steelpuxnastik/ESPtoPC_Wireless_Remote_Switch/README.md

# ESPtoPC Wireless Remote Switch

Remote power-on / reset / force-shutdown for a desktop PC over WiFi, using an ESP-01 wired to the motherboard's front-panel header, plus an OpenWrt app (LuCI page + CLI) to manage one or more of these boards.

Built for the case where a PC needs to be turned on remotely even after a power outage — before the OS is up, before Wake-on-LAN is usable — by literally pressing the physical power button in software.

## Repo layout

```
├── esptopc_poweron_remote_pcb/
│   ├── esptopc_poweron_remote_pcb.kicad_pro   KiCad project
│   ├── esptopc_poweron_remote_pcb.kicad_pcb   Board layout
│   ├── esptopc_poweron_remote_pcb.kicad_sch   Schematic
│   └── esptopc_poweron_remote_pcb.kicad_prl   KiCad local project settings
├── esptopc_poweron_remote/
│   └── esptopc_poweron_remote.ino             ESP8266 (ESP-01) firmware
└── openwrt_program/
    └── deploy.sh                              One-shot installer for the OpenWrt side:
                                               LuCI app + CLI tool + handshake listener
```

## How it fits together

```
[ESP-01 board]  --HTTP-->  [OpenWrt router]  <--LuCI/SSH--  [you]
   |    ^                     |
   |    |                     |-- LuCI page: device list, status, buttons
   |    `-- commands sent      -- CLI (`esptopcrsw`): menu + one-liners
   |        by OpenWrt         -- receives handshake/heartbeat from ESP
   `-- wired to PC's
       PWR_SW / RESET_SW
       header + reads the
       power-LED line
```

- The ESP-01 runs its own tiny HTTP server (power on / force off / reset / status) and also announces itself to the router (MAC + a fixed identifying string) so it shows up in LuCI ready to be named and saved.
- The OpenWrt side is the "brain": it tracks device state, decides which buttons make sense to show (e.g. no point offering "Reset" on a PC that's already off), and is what you actually interact with — LuCI in a browser, or `esptopcrsw` over SSH.

## Hardware (KiCad project)

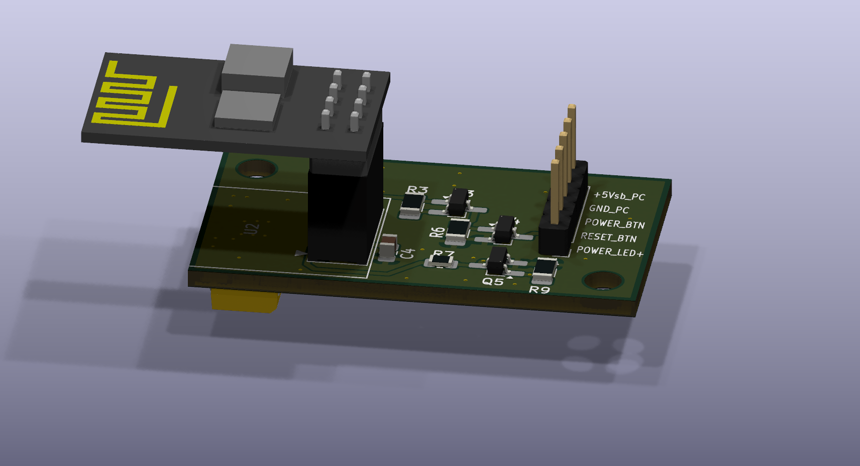
[picture p1: pictures/esptopc_poweron_remote_pcb_1.png]
side

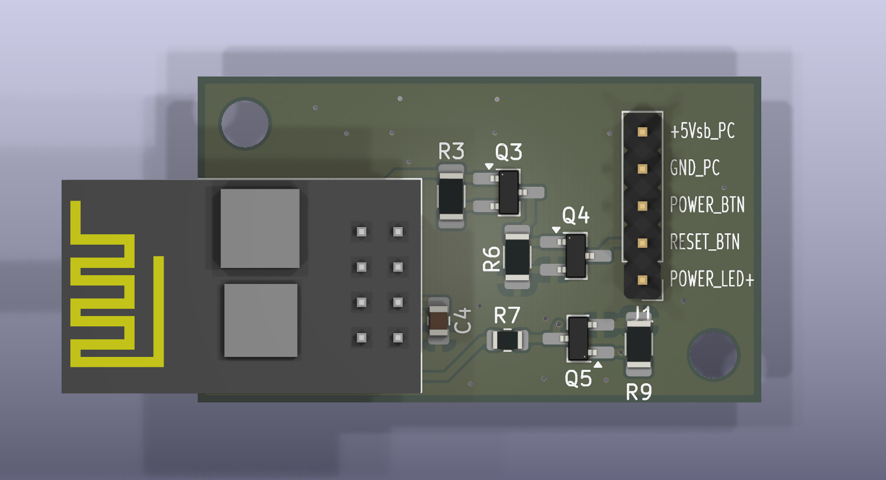
[picture p2: pictures/esptopc_poweron_remote_pcb_3.png]
top

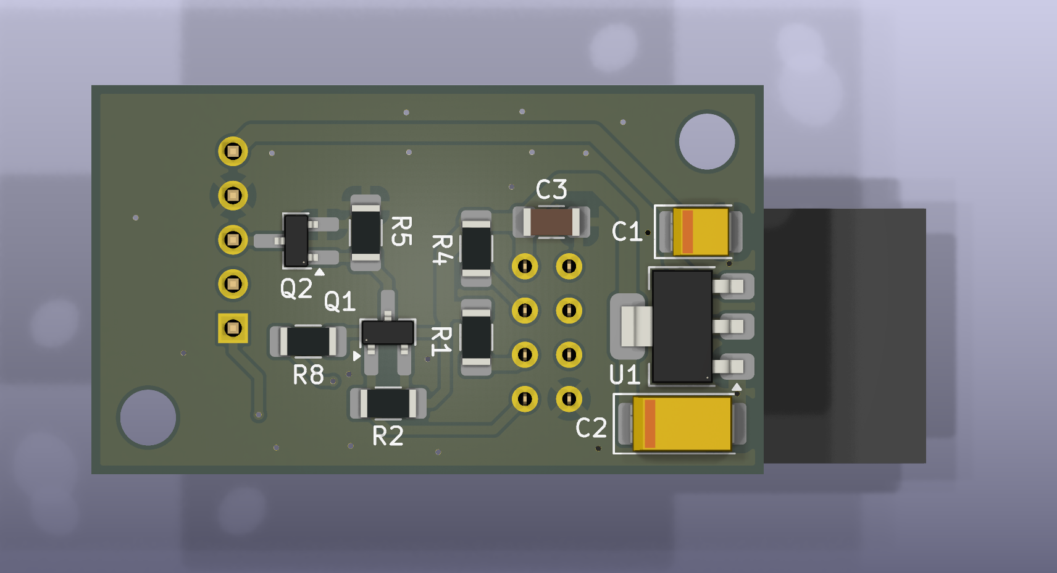
[picture p3: pictures/esptopc_poweron_remote_pcb_2.png]
bottom


Open `esptopc_poweron_remote_pcb.kicad_pro` in KiCad. The board:

- Regulates the PC's 5V standby rail down to 3.3V (AMS1117-3.3) to power the ESP-01;
- Uses two small MOSFET pairs (PMOS+NMOS per line) so the ESP's GPIO1 (TX) and GPIO3 (RX) can pull the motherboard's **PWR_SW** and **RESET_SW** header pins low, exactly like pressing the physical buttons;
- Reads the motherboard's power-LED line through a third MOSFET into GPIO2, to sense whether the PC is currently on (active-low: LOW = on);
- Leaves GPIO0 completely unused/unconnected on purpose, to avoid accidentally dropping into the bootloader.

### List of required components for board assembly

| Reference | Qty | Value | Footprint | Datasheet |
| :--- | :--- | :--- | :--- | :--- |
| **C1** | 1 | 22uF | Capacitor_Tantalum_SMD:CP_EIA-3528-21_Kemet-B_HandSolder | |
| **C2** | 1 | 150uF | Capacitor_Tantalum_SMD:CP_EIA-6032-28_Kemet-C_HandSolder | |
| **C3** | 1 | 100nF | Capacitor_SMD:C_1206_3216Metric_Pad1.33x1.80mm_HandSolder | |
| **C4** | 1 | 1uF | Capacitor_SMD:C_0805_2012Metric_Pad1.18x1.45mm_HandSolder | |
| **J1** | 1 | Conn_01x05_Pin | Connector_PinHeader_2.54mm:PinHeader_1x05_P2.54mm_Vertical | |
| **Q1, Q3** | 2 | IRLML6402 | Package_TO_SOT_SMD:SOT-23_Handsoldering | |
| **Q2, Q4, Q5** | 3 | IRLML2502 | Package_TO_SOT_SMD:SOT-23_Handsoldering | |
| **R1, R2, R3, R4, R5, R6, R8, R9** | 8 | 10k | Resistor_SMD:R_1206_3216Metric_Pad1.30x1.75mm_HandSolder | |
| **R7** | 1 | 1k | Resistor_SMD:R_0805_2012Metric | |
| **U1** | 1 | AMS1117-3.3 (fixed 3.3V version) | Package_TO_SOT_SMD:SOT-223-3_TabPin2 | [Datasheet](http://www.advanced-monolithic.com/pdf/ds1117.pdf) |
| **U2** | 1 | ESP-01 | RF_Module:ESP-01 | [Datasheet](https://aithinker-static.oss-cn-shenzhen.aliyuncs.com/docs/_media_old/esp-01_product_specification_en.pdf) |

## Connection to PC

Connector `J1` (5-pin) goes to the motherboard. Pinout as drawn in the schematic:

| J1 pin | Signal | Connect to |
| :--- | :--- | :--- |
| 1 | LED+ | Power-LED (PLED+) pin of the motherboard's front-panel header |
| 2 | RESET | Signal pin of the RESET_SW header (not the ground pin) |
| 3 | POWER | Signal pin of the PWR_SW header (not the ground pin) |
| 4 | GND | Ground |
| 5 | +5V | +5V standby — must stay powered while the PC is off |

Front-panel header pinouts differ between motherboards, so check the manual of yours before connecting.

## Firmware (`esptopc_poweron_remote.ino`)

Flash with the Arduino IDE (ESP8266 core) via a USB-serial adapter. **TX/RX are used to drive the buttons**, so there's no Serial debug output. Flashing needs the special adapter, so you need to disconnect ESP-01 from the board first.

Before flashing, edit near the top of the file:

- `WIFI_SSID` / `WIFI_PASS` — your network;
- `DEVICE_PASSWORD` — a shared password string. The board sends it to the router in the handshake (so the router knows it's one of yours), and it is also the seed of the per-device command key (see **Security** below). It must match `esptopcrsw.settings.password` on the router; the default `poweron-esp01` is already the same on both sides, so you don't have to change it;
- `POWER_SHORT_MS = 300` - A short press of the Power button. The configured press duration setting should work in most cases;
- `POWER_SOFTOFF_MS  = 4500` - Hold the Power button for the BIOS "soft-off delay" (e.g. Gigabyte: *Soft-Off by PWR-BTN = Delay 4 Sec*: a short press only suspends the PC, holding the button for 4+ seconds turns it off). It is only a fallback: the router normally sends its own time, see **Button press times** below;
- `POWER_FORCEOFF_MS = 5000` - Long-press the Power button to force the system unit to shut down. The required duration of the press can vary significantly between different computers; if it does not work, you will need to experiment to find the right timing;
- `RESET_SHORT_MS = 300` - A short press of the Reset button. The configured press duration setting should work in most cases;
- `WIFI_RETRY_MS = 30000` - While the board is not connected to WiFi (for example, the router is still booting after a power outage), it retries the connection every 30 seconds, forever;
- `HANDSHAKE_INTERVAL_MS = 10000` - Once the board is on WiFi, until the OpenWrt app acknowledges it, it announces itself every 10 seconds;
- `HEARTBEAT_INTERVAL_MS = 90000` - After the acknowledgment the board repeats the announcement every 90 seconds to show it is still alive.

How the heartbeat is used: the router stores the time of the last announcement in RAM, continuously, whether or not anyone has the LuCI page open. A device is shown as Offline if nothing was heard from it for 5 minutes. The PC's on/off state does not come from the heartbeat — it is read live from the board when you open the page (and every 15 seconds while the page stays open). The only case with a wait is right after the router itself reboots: its RAM is empty, so a device shows as Offline until its next announcement (up to the heartbeat interval). A shorter `HEARTBEAT_INTERVAL_MS` shortens that wait.

The board finds the router automatically (`WiFi.gatewayIP()`, no IP to hardcode) and keeps retrying forever, so boot order after a power outage doesn't matter.

HTTP endpoints the board exposes (all require `?key=...`, see below):

| Endpoint | Effect |
|---|---|
| `GET /power/on[?ms=N]` | Short press of the power button (default `POWER_SHORT_MS`; limited to 100–2000) |
| `GET /power/hold[?ms=N]` | Hold the power button (default `POWER_SOFTOFF_MS`; limited to 500–10000) |
| `GET /power/off[?ms=N]`  | Long press, force shutdown (default `POWER_FORCEOFF_MS`; limited to 1000–15000) |
| `GET /reset[?ms=N]` | Press of the reset button (default `RESET_SHORT_MS`; limited to 100–2000) |
| `GET /status` | `{"pc_status":"on"\|"off"}` |

All permission logic (e.g. "don't offer Reset while the PC is off") lives on the OpenWrt side, not in the firmware — the board just does what it's told and reports state.

## OpenWrt app (`deploy.sh`)

Self-contained installer — no package manager involved, just copies files to their real system paths and (re)starts the relevant services. Built against OpenWrt 25.x (APK-based, modern JSON-based LuCI menu/ACL — the classic Lua-controller style LuCI apps won't work the same way on this version).

### Install

On Windows, in CMD, I use this to copy `deploy.sh` to the router:
```CMD
scp X:\way\to\your\deploy.sh root@<router-ip>:/root/
```
After this, connect to the router over SSH and install the app:
```sh
ssh root@<router-ip>
sh deploy.sh
```

Re-running `deploy.sh` after an update is safe — it won't wipe devices you've already added (`/etc/config/esptopcrsw` is only created if missing).

What it sets up:
- LuCI page under **Services → ESPtoPC Wireless Remote Switch**: device table with live status (On / Off / Offline), buttons that adapt to state, add-device picker (from the router's DHCP client list or typed by hand), and a banner for boards that announced themselves but aren't saved yet (it has a Dismiss button; a dismissed board shows up again when it announces itself next time). **Initial setup and adding devices is carried out only in LuCI's ESPtoPC Wireless Remote Switch program page**;
- `esptopcrsw` CLI (see below; use it only after the setup in LuCI is done and checked);
- A second `uhttpd` instance on port 8090 that receives the handshake/heartbeat from ESP boards;
- `rpcd`/`ubus` backend (`/usr/libexec/rpcd/esptopcrsw`) that both the LuCI page and the CLI talk to.

### CLI

> **Important:**
> Use the CLI only after the program is set up in LuCI and you have checked that everything works as you expect: devices are added, the status is shown correctly, and the press times (the **Settings** button of each device) fit your PC. The CLI does not add devices or change settings, it only sends commands using what is configured in LuCI.

```sh
esptopcrsw                     # interactive menu, a convenient alternative to manual command entry
esptopcrsw list                # table of devices + status
esptopcrsw poweron <name>      # power on (or sleep, if already on)
esptopcrsw softoff <name>      # soft-off: hold Power for the BIOS delay (see below; `hold` is an alias)
esptopcrsw off <name>          # force power off (long hold)
esptopcrsw reset <name>
esptopcrsw check <name>        # check/restore connection
esptopcrsw help                # show help (list of commands and hints)
esptopcrsw lang [en|ru|uk]     # interface language (remembered)
```

Any of `poweron` / `softoff` / `off` / `reset` asks for a one-letter confirmation first (`y/N`) naming the device and the action, so a stray keypress can't send a command to the wrong PC. If a device looks offline when you run a command, the CLI tries to reconnect first and reports what happened, instead of failing silently.

### Button press times and Soft-Off

**Soft-Off is optional and aimed at Gigabyte boards.** Some Gigabyte BIOSes have *Soft-Off by PWR-BTN* (*Instant-Off* / *Delay 4 Sec*). With *Delay 4 Sec* a short press only suspends the PC, and a press held for 4 seconds shuts it down normally. If your board has no such option, you only need **Off / Sleep** and **Force Off**. The same action also covers any other case where the PC expects a Power press of a specific length: set that length as the hold time.

Power button actions, from shortest to longest: **Off / Sleep** (short press, what the PC does depends on its power settings), **Soft-Off (X s)** (hold for the BIOS soft-off delay), **Force Off** (long hold, `POWER_FORCEOFF_MS`), and **Reset**.

If a short press does not shut the PC down (on Gigabyte boards the BIOS option *Soft-Off by PWR-BTN* set to *Delay 4 Sec* makes a short press only suspend it), use **Soft-Off (X s)**. `X` is set with the **Settings** button in LuCI (in seconds) or on the router, no reflashing needed:

All press times are set per device in LuCI, in seconds, no reflashing needed: the **Settings** button in the device's *Manage* column (an empty field means the built-in value). The same options can be set with `uci` in the device section:

```sh
uci set esptopcrsw.@device[0].soft_off_ms='6000'    # the first device, ms
uci commit esptopcrsw
```

| Option | Action | Default | Allowed, ms |
|---|---|---|---|
| `power_short_ms` | Off / Sleep (short Power press) | 300 | 100–2000 |
| `soft_off_ms` | Soft-Off (Power hold for the BIOS delay) | 4500 | 500–10000 |
| `force_off_ms` | Force Off (long Power hold) | 5000 | 1000–15000 |
| `reset_ms` | Reset | 300 | 100–2000 |

The Soft-Off button label in LuCI and in the CLI shows the current value for that device. Unlike the short press, this button is not blocked in the first minute after power-on.

### Security

There's no login/password on the ESP's HTTP server itself — instead:

- **Handshake** (ESP → router): the board POSTs its MAC and `DEVICE_PASSWORD` to the router on boot/periodically, so the router knows it's genuinely this project's firmware announcing itself. It only filters out random devices, and it is sent in plain text.
- **Commands** (router → ESP): every `/power/on`, `/power/hold`, `/power/off`, `/reset`, `/status` call requires `?key=<12-hex-chars>`, computed as `md5(MAC:DEVICE_PASSWORD)` truncated to 12 characters — the same formula on both sides, so no separate secret needs to be distributed or synced per board. Each board gets a different key because its MAC is different. This stops a stray browser tab pointed at the board's IP from doing anything. It is **not** protection against someone who deliberately reads this repo (the formula and the default password are public), and it's **not encryption**: the key is part of the URL, so anyone sniffing the WiFi traffic can read it in plain text. Good enough for "don't let someone on the LAN poke it by accident", not meant to survive a hostile network. If you want more than the default, set your own string in `DEVICE_PASSWORD` in the firmware and in `uci set esptopcrsw.settings.password='...'` on the router.

## Known rough edges

- The rpcd/JS/LuCI layer was written against documented conventions for modern OpenWrt (menu.d/acl.d JSON, JS views over ubus) but hasn't been exhaustively tested beyond this one setup — if something in LuCI breaks after an OpenWrt upgrade, that's the first place to look.
- `busybox tr` on some builds doesn't support POSIX character classes (`[:lower:]`/`[:upper:]`) — the scripts here use explicit ranges (`a-z`/`A-Z`) everywhere for that reason; keep that in mind if you extend them.
- MAC addresses are stored/compared uppercase throughout, to avoid the same device getting registered twice under different casing.

## To-Do-List
- PCB variant based on ESP12E, that will be simpler in some areas in terms of harnessing components, plus it's protected by default from all the side effects that previously had to be addressed by monitoring the input from the PC's operating status pin. 
- Create a simplified default pass-through connection for all connectors, plus the ability to connect to the power supply with just one 5Vsb wire.
