steelpuxnastik/ESPtoPC_Wireless_Remote_Switch/esptopc_poweron_remote_pcb/esptopc_poweron_remote_pcb.kicad_pcb

## KiCad design esptopc_poweron_remote_pcb/esptopc_poweron_remote_pcb.kicad_pcb (2026-11-12)

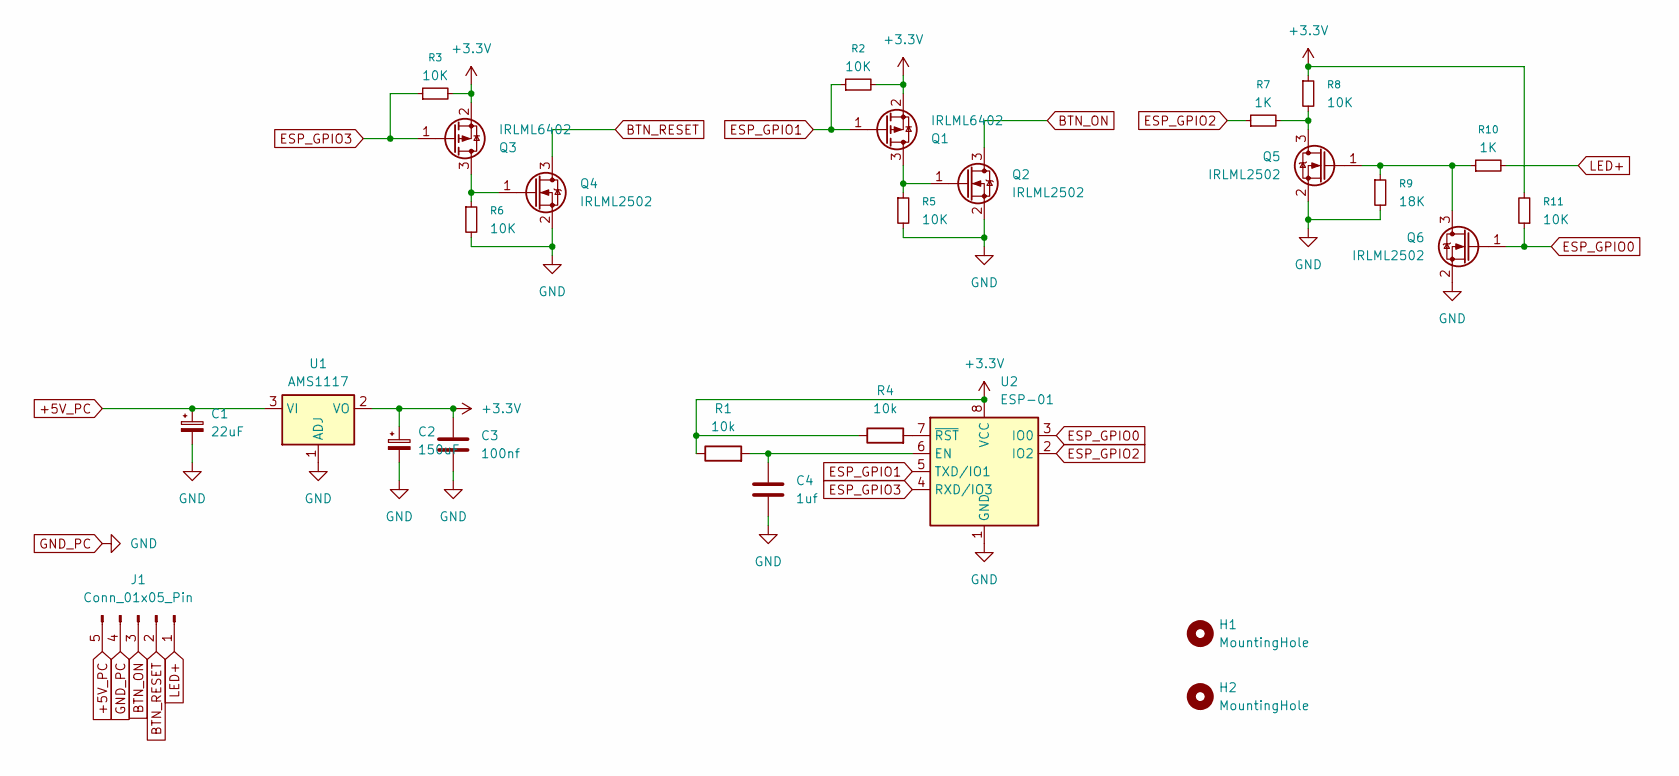
[picture p4: schematic esptopc_poweron_remote_pcb.kicad_sch]

Parts:
C1: 22uF; CP_EIA-3528-21_Kemet-B_HandSolder
C2: 150uF; CP_EIA-6032-28_Kemet-C_HandSolder
C3: 100nf; C_1206_3216Metric_Pad1.33x1.80mm_HandSolder
C4: 1uf; C_0805_2012Metric_Pad1.18x1.45mm_HandSolder
H1, H2: MountingHole; MountingHole_3.2mm_M3
J1: Conn_01x05_Pin; PinHeader_1x05_P2.54mm_Vertical
Q1, Q3: IRLML6402; SOT-23_Handsoldering
Q2, Q4, Q5, Q6: IRLML2502; SOT-23_Handsoldering
R1, R4: 10k; R_1206_3216Metric_Pad1.30x1.75mm_HandSolder
R2, R3, R5, R6, R8, R11: 10K; R_1206_3216Metric_Pad1.30x1.75mm_HandSolder
R7: 1K; R_0805_2012Metric
R9: 18K; R_0805_2012Metric_Pad1.20x1.40mm_HandSolder
R10: 1K; R_0805_2012Metric_Pad1.20x1.40mm_HandSolder
U1: AMS1117; SOT-223-3_TabPin2
U2: ESP-01

Connections:
+3.3V: C2.1, C3.1, Q1.2 (S), Q3.2 (S), R1.1, R2.2, R3.2, R4.1, R8.1, R11.2, U1.2 (VO), U2.8 (VCC)
+5V_PC: C1.1, J1.5, U1.3 (VI)
BTN_ON: J1.3, Q2.3 (D)
BTN_RESET: J1.2, Q4.3 (D)
ESP_GPIO0: Q6.1 (G), R11.1, U2.3 (IO0)
ESP_GPIO1: Q1.1 (G), R2.1, U2.5 (TXD/IO1)
ESP_GPIO2: R7.1, U2.2 (IO2)
ESP_GPIO3: Q3.1 (G), R3.1, U2.4 (RXD/IO3)
GND_PC: C1.2, C2.2, C3.2, C4.2, J1.4, Q2.2 (S), Q4.2 (S), Q5.2 (S), Q6.2 (S), R5.2, R6.2, R9.2, U1.1 (ADJ), U2.1 (GND)
LED+: J1.1, R10.2
unnamed: Q1.3 (D), Q2.1 (G), R5.1
unnamed: Q3.3 (D), Q4.1 (G), R6.1
unnamed: Q5.3 (D), R7.2, R8.2
unnamed: Q5.1 (G), Q6.3 (D), R9.1, R10.1
unnamed: C4.1, R1.2, U2.6 (EN)
unnamed: R4.2, U2.7 (~RST)

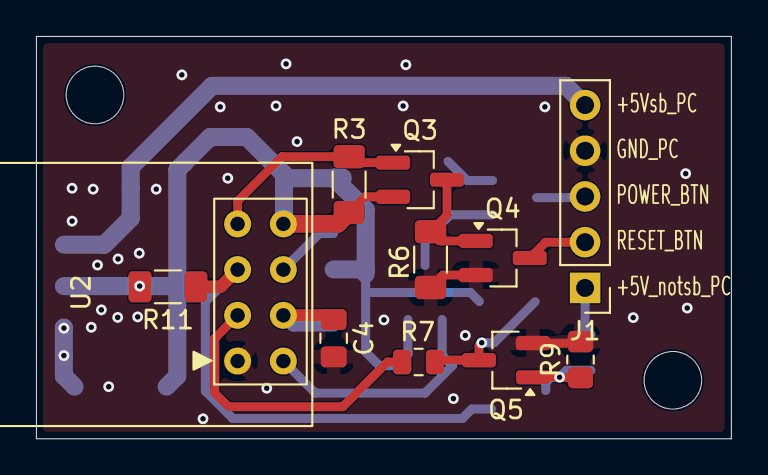
[picture p5: board esptopc_poweron_remote_pcb.kicad_pcb from above]

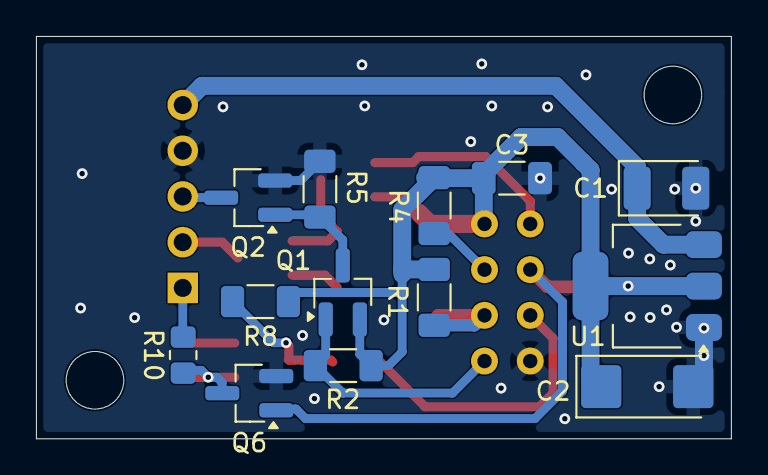
[picture p6: board esptopc_poweron_remote_pcb.kicad_pcb from below]

Board: 2 copper layers, 38.6 x 22.4 mm, 26 parts (13 on the bottom side), 16 nets.
