steelpuxnastik/ESPtoPC_Wireless_Remote_Switch/esptopc_poweron_remote/esptopc_poweron_remote.ino

/*
 * ESP-01: удалённое управление кнопками Power/Reset ПК через HTTP.
 * -----------------------------------------------------------------
 * GPIO1 (TX)  -> затвор Q1 (Power button). LOW = кнопка нажата, HIGH = отпущена.
 * GPIO3 (RX)  -> затвор Q3 (Reset button). LOW = кнопка нажата, HIGH = отпущена.
 * GPIO2       -> вход, статус ПК: LOW = ПК включен, HIGH = ПК выключен.
 * GPIO0       -> затвор Q7 (ключ статуса). Обычно отпущен (INPUT, подтяжка R10 = HIGH,
 *                Q7 открыт, затвор Q5 на земле, GPIO2 не прижат). Опускается в LOW только
 *                на ~2 мс в pcIsOn(), чтобы Q5 мог показать статус на GPIO2.
 *
 * Serial отключен полностью: TX/RX заняты под кнопки, а мусор от
 * Arduino Serial.begin() поверх штатного ROM boot-лога только добавил бы риска.
 * Сам ROM boot-лог на TX (до старта setup()) программно не убрать -
 * это особенность загрузчика ESP8266, а не этого скетча.
 *
 * HTTP-эндпоинты (без внутренних проверок — вся логика разрешений на OpenWrt):
 *   GET /power/on[?ms=N]  - короткое нажатие Power.
 *   GET /power/hold - удержание Power заданное время (BIOS «Soft-Off by PWR-BTN: Delay N Sec»).
 *                     Время: ?ms=N (роутер берёт из UCI soft_off_ms), без параметра - POWER_HOLD_MS.
 *                     Нужно для плат Gigabyte с такой опцией и для любых ПК, которым нужно нажатие Power особой длины.
 *   GET /power/off[?ms=N] - длинное удержание Power (принудительное выключение).
 *   GET /reset[?ms=N]     - короткое нажатие Reset.
 *   GET /status     - {"pc_status":"on"|"off"}
 *
 * Плюс: ESP сама стучится на OpenWrt-программу (POST /announce на шлюз,
 * порт OPENWRT_PORT) - хендшейк раз в 10с до первого ack, потом
 * heartbeat раз в ~1.5 мин.
 */

#include <ESP8266WiFi.h>
#include <ESP8266WebServer.h>
#include <ESP8266HTTPClient.h>
#include <MD5Builder.h>

// ---- Настройки сети ----
const char* WIFI_SSID = "ВАШ_SSID";
const char* WIFI_PASS = "ВАШ_ПАРОЛЬ";

// ---- Пины ----
const uint8_t PIN_POWER     = 1; // TX -> Q1 (Power)
const uint8_t PIN_RESET     = 3; // RX -> Q3 (Reset)
const uint8_t PIN_PC_STATUS = 2; // вход статуса ПК (LOW = ON)
const uint8_t PIN_STATUS_EN = 0; // GPIO0 -> затвор Q7: LOW = статус на GPIO2 доступен; отпущен = защита
const uint8_t STATUS_SETTLE_MS = 2; // время установления цепи Q5 после опускания GPIO0


// ---- OpenWrt: хендшейк/heartbeat ----
const uint16_t OPENWRT_PORT = 8090;      // порт программы на роутере (сверим при написании OpenWrt-части)
const char* OPENWRT_PATH = "/cgi-bin/announce";  // единая точка приёма хендшейка/heartbeat
const char* DEVICE_PASSWORD = "poweron-esp01"; // общий пароль: метка в хендшейке + основа ключа команд md5(MAC:пароль); совпадает с uci get esptopcrsw.settings.password
const uint16_t HTTP_PORT = 80;           // наш собственный порт (для информации роутеру)

const uint32_t HANDSHAKE_INTERVAL_MS = 10000;  // пока не зарегистрированы - раз в 10с
const uint32_t HEARTBEAT_INTERVAL_MS = 90000;  // после регистрации - раз в 1.5 мин
const uint32_t WIFI_RETRY_MS = 30000;          // нет WiFi (роутер ещё не поднялся) - повторное подключение раз в 30с

bool registeredWithOpenWrt = false;
uint32_t lastAnnounceMs = 0;
uint32_t lastWifiRetryMs = 0;

// ---- Тайминги нажатий (мс) ----
// Это стартовые/безопасные значения (в т.ч. по ATX-спеке: >=4с на
// материнке гарантированно триггерит hard power-off).
// Для конкретной твоей мамки их стоит проверить и при необходимости
// подправить - вынесены отдельными константами специально для этого.
// Значения по умолчанию: используются, если роутер не передал ?ms=N
uint32_t POWER_SHORT_MS    = 300;   // короткое нажатие Power -> включение
uint32_t POWER_SOFTOFF_MS  = 4500;  // удержание Power для BIOS «Delay 4 Sec» (4 с + запас)
uint32_t POWER_FORCEOFF_MS = 5000;  // удержание Power -> принудительное выключение
uint32_t RESET_SHORT_MS    = 300;   // короткое нажатие Reset

// Допустимые границы ?ms= (те же, что на роутере)
const long POWER_SHORT_MIN_MS    = 100,  POWER_SHORT_MAX_MS    = 2000;
const long POWER_SOFTOFF_MIN_MS  = 500,  POWER_SOFTOFF_MAX_MS  = 10000;
const long POWER_FORCEOFF_MIN_MS = 1000, POWER_FORCEOFF_MAX_MS = 15000;
const long RESET_MIN_MS          = 100,  RESET_MAX_MS          = 2000;

ESP8266WebServer server(80);

bool pcIsOn() {
  // GPIO0 в LOW только на время чтения, чтобы любой внезапный сброс
  // почти наверняка застал его отпущенным (иначе ESP уйдёт в загрузчик).
  pinMode(PIN_STATUS_EN, OUTPUT);
  digitalWrite(PIN_STATUS_EN, LOW);
  delay(STATUS_SETTLE_MS);
  bool on = (digitalRead(PIN_PC_STATUS) == LOW);
  pinMode(PIN_STATUS_EN, INPUT); // отпустить: R10 поднимает GPIO0, Q7 снова закрывает Q5
  return on;
}

void pressButton(uint8_t pin, uint32_t durationMs) {
  digitalWrite(pin, LOW);
  delay(durationMs);
  digitalWrite(pin, HIGH);
}

String commandKey() {
  MD5Builder md5;
  md5.begin();
  md5.add(WiFi.macAddress() + ":" + String(DEVICE_PASSWORD));
  md5.calculate();
  return md5.toString().substring(0, 12);
}

bool checkKey() {
  if (server.arg("key") != commandKey()) {
    server.send(403, "text/plain", "bad key");
    return false;
  }
  return true;
}

// Время нажатия: ?ms=N от роутера, ограниченное [minMs..maxMs]; без параметра - defMs
uint32_t requestMs(uint32_t defMs, long minMs, long maxMs) {
  long ms = server.hasArg("ms") ? server.arg("ms").toInt() : (long)defMs;
  if (ms < minMs) ms = minMs;
  if (ms > maxMs) ms = maxMs;
  return (uint32_t)ms;
}

void handlePowerOn() {
  if (!checkKey()) return;
  uint32_t ms = requestMs(POWER_SHORT_MS, POWER_SHORT_MIN_MS, POWER_SHORT_MAX_MS);
  pressButton(PIN_POWER, ms);
  server.send(200, "text/plain", String("Power short-press ") + String(ms) + " ms sent");
}

void handlePowerHold() {
  if (!checkKey()) return;
  uint32_t ms = requestMs(POWER_SOFTOFF_MS, POWER_SOFTOFF_MIN_MS, POWER_SOFTOFF_MAX_MS);
  pressButton(PIN_POWER, ms);
  server.send(200, "text/plain", String("Power soft-off hold ") + String(ms) + " ms sent");
}

void handlePowerOff() {
  if (!checkKey()) return;
  uint32_t ms = requestMs(POWER_FORCEOFF_MS, POWER_FORCEOFF_MIN_MS, POWER_FORCEOFF_MAX_MS);
  pressButton(PIN_POWER, ms);
  server.send(200, "text/plain", String("Power long-press (force off) ") + String(ms) + " ms sent");
}

void handleReset() {
  if (!checkKey()) return;
  uint32_t ms = requestMs(RESET_SHORT_MS, RESET_MIN_MS, RESET_MAX_MS);
  pressButton(PIN_RESET, ms);
  server.send(200, "text/plain", String("Reset press ") + String(ms) + " ms sent");
}

void handleStatus() {
  if (!checkKey()) return;
  server.send(200, "application/json",
    String("{\"pc_status\":\"") + (pcIsOn() ? "on" : "off") + "\"}");
}

void sendAnnounce() {
  WiFiClient client;
  HTTPClient http;
  String url = "http://" + WiFi.gatewayIP().toString() + ":" + String(OPENWRT_PORT) + OPENWRT_PATH;
  String payload = String("{\"mac\":\"") + WiFi.macAddress() +
                    "\",\"password\":\"" + DEVICE_PASSWORD +
                    "\",\"port\":" + String(HTTP_PORT) + "}";

  http.begin(client, url);
  http.addHeader("Content-Type", "application/json");
  int code = http.POST(payload);
  http.end();

  registeredWithOpenWrt = (code == 200);
  lastAnnounceMs = millis();
}

void setup() {
  // Кнопочные пины сразу в неактивное состояние (HIGH), до WiFi.
  pinMode(PIN_POWER, OUTPUT);
  digitalWrite(PIN_POWER, HIGH);
  pinMode(PIN_RESET, OUTPUT);
  digitalWrite(PIN_RESET, HIGH);

  pinMode(PIN_STATUS_EN, INPUT); // GPIO0 отпущен: R10 держит HIGH, Q7 открыт
  pinMode(PIN_PC_STATUS, INPUT); // внешний R8 уже подтягивает, INPUT_PULLUP не нужен

  WiFi.mode(WIFI_STA);
  WiFi.begin(WIFI_SSID, WIFI_PASS);
  lastWifiRetryMs = millis();
  while (WiFi.status() != WL_CONNECTED) {
    delay(200); // без Serial - просто ждём, ретраи бесконечны
    if (millis() - lastWifiRetryMs >= WIFI_RETRY_MS) {
      lastWifiRetryMs = millis();
      WiFi.begin(WIFI_SSID, WIFI_PASS); // роутер ещё не поднялся - пробуем снова
    }
  }

  server.on("/power/on", HTTP_GET, handlePowerOn);
  server.on("/power/hold", HTTP_GET, handlePowerHold);
  server.on("/power/off", HTTP_GET, handlePowerOff);
  server.on("/reset", HTTP_GET, handleReset);
  server.on("/status", HTTP_GET, handleStatus);
  server.begin();
}

void loop() {
  server.handleClient();

  // Если WiFi отвалился - переподключаемся, не блокируя работу кнопок
  // дольше необходимого (begin() сам по себе не блокирующий).
  if (WiFi.status() != WL_CONNECTED) {
    registeredWithOpenWrt = false; // при обрыве WiFi - хендшейк заново
    if (millis() - lastWifiRetryMs >= WIFI_RETRY_MS) {
      lastWifiRetryMs = millis();
      WiFi.begin(WIFI_SSID, WIFI_PASS);
    }
    delay(100);
    return; // нет смысла стучаться в OpenWrt без WiFi
  }

  uint32_t now = millis();
  uint32_t interval = registeredWithOpenWrt ? HEARTBEAT_INTERVAL_MS : HANDSHAKE_INTERVAL_MS;
  if (now - lastAnnounceMs >= interval) {
    sendAnnounce();
  }
}
