steelpuxnastik/ESPtoPC_Wireless_Remote_Switch/(commit log)

2026-09-25 Initial commit
    Everything more or less working :)
    [esptopc_poweron_remote_pcb.kicad_pcb, esptopc_poweron_remote_pcb.kicad_sch]
2026-09-25 Adding help to program
    Adding help buttons to LuCI-page of program and to CLI. The content of help pages will be updated as issues and points of confusion arise. Perhaps in the future, I’ll forget something myself and realize exactly what’s needed. :)
2026-10-01 Fix for certain issues
    Fix for certain issues preventing the buttons from working.
    [esptopc_poweron_remote.ino]
2026-10-30 Потерялась дорожка. Нашлась
    [esptopc_poweron_remote_pcb.kicad_pcb]
2026-11-10 Firmware addition
    an addition to the firmware where pin 0 controls the signal input pin POWER_LED+
    And fixing PCB for it in work
    [esptopc_poweron_remote_pcb.kicad_sch]
2026-11-11 refactor deploy.sh + pcb final fix
    [esptopc_poweron_remote_pcb.kicad_pcb, esptopc_poweron_remote_pcb.kicad_sch]
2026-11-12 Add Soft-Off (timed Power hold) action + Settings dialog
    Firmware:
    - new GET /power/hold[?ms=N]: holds Power for N ms (default POWER_HOLD_MS = 4500,
    clamped to 500..10000), for BIOS "Soft-Off by PWR-BTN = Delay N Sec"
    Router (deploy.sh):
    - new UCI option soft_off_ms (default 4500, clamped to 500..10000)
    - rpcd: new action power_hold (allowed only when PC is on, not blocked after
    power-on, waits hold/1000+6 s for the reply); list returns soft_off_ms
    - rpcd: new methods get_settings / set_settings (+ ACL, rpc_list, dispatch)
    - LuCI: "Soft-Off (X s)" button, label follows soft_off_ms; "Settings" button
    next to "Help" edits the hold time in seconds
    - CLI: "Soft-Off (X s)" menu item with t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
    [esptopc_poweron_remote_pcb.kicad_pcb]
2026-11-12 Update deploy.sh
    Сorrection of some inscriptions in CLI.
2026-11-13 Move press times from firmware constants to per-device settings
    - firmware: /power/on, /power/off, /reset accept ?ms=N like /power/hold; the
    constants are now only fallbacks (POWER_LONG_MS -> POWER_FORCEOFF_MS,
    POWER_HOLD_MS -> POWER_SOFTOFF_MS), each ?ms= is limited to a safe range
    - router: press times are UCI options (power_short_ms, soft_off_ms,
    force_off_ms, reset_ms) per device, then for all devices, then default;
    every command sends its time to the board
    - rpcd: get_settings / set_settings work for one device or for all
    - LuCI: Settings dialog next to Help (all devices) and in the Manage
    column (one device), values in seconds
    - CLI: Soft-Off menu item shows the time of the s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
    [esptopc_poweron_remote.ino]
2026-11-13 Deleting global settings from the structure
    - LuCI: Settings dialog in the Manage column of each device, values in seconds
    - router: press times are per-device UCI options (power_short_ms, soft_off_ms, force_off_ms, reset_ms), built-in default if not set;
    - rpcd: get_settings / set_settings work for one device (mac is required)
